PhilippRom/Styrocutter-1.0/Renderings/03 Stangenhalter.jpg

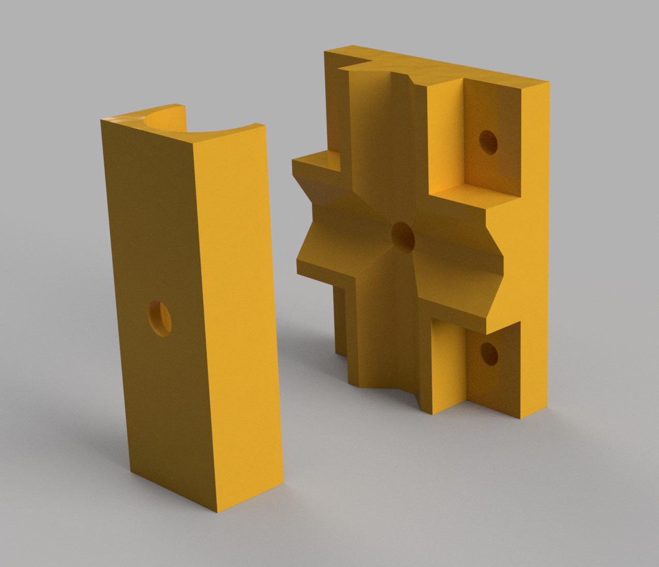
Renderings/03 Stangenhalter.jpg
