PhilippRom/Styrocutter-1.0/Renderings/06 Queranschlag.jpg

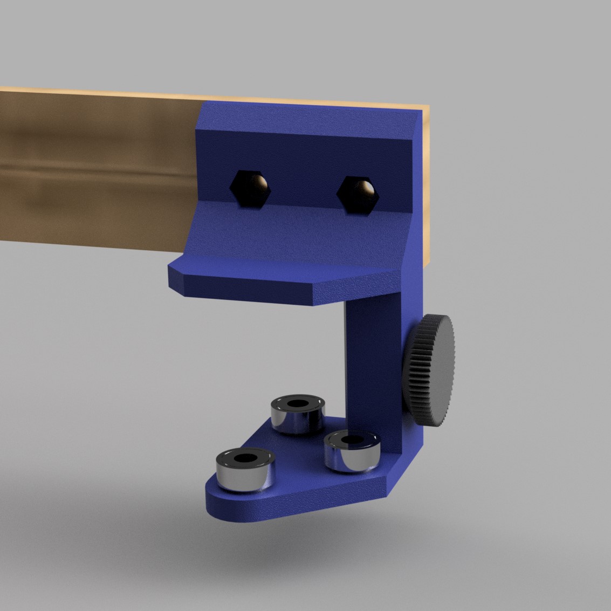
Renderings/06 Queranschlag.jpg
