PhilippRom/Styrocutter-1.0/README.md

# Styrocutter-1.0
Der Styrocutter für die Schule wurde im Rahmen einer Bachelorarbeit entworfen.
Er basiert auf einem einfachen Widerstandsdraht, welcher durch Erhitzung diverses Material, wie Styropor, Styrodur und Schaumstoffe schneiden kann.

Der Styrocutter hat das Ziel, die goldene Mitte zwischen billigen Plastik-Geräten (die es auf Thingiverse in vielen Variationen gibt) und teuren Aluminiumgeräten zu sein.
Durch die Kombination aus 3D gedruckten Teilen, sowie soliden Materialien, die in Baumärkten leicht erhältlich sind erreicht er eine sehr gute Qualität bei gleichzeitig niedrigem Preis.

Mittels des kugelgelagerten Queranschlags und der passgenauen Spannmanschette sind Schneiddicke, sowie Winkel und Spannung des Drahts schnell eingestellt.
Die Drahtretention im Tisch ist so ausgeführt, dass der Draht ohne das Gerät umdrehen zu müssen gewechselt werden kann.
Genauso wurde die Retention des Arms so konstruiert, dass das Gerät schnell, platzsparend in Fächern oder Regalen verstaut werden kann.
Ein zusätzlich ausdruckbares Add-On ermöglicht sogar Kreisschnitte.

Die Stromversorgung wird mittels Bananenstecker eines Labornetzteils gewährleistet. (gewöhnlich werden 5V und ca. 2A benötigt)

Durch das modulare System und die robusten Teile ist das Gerät gut skalierbar, sodass der Schneidtisch größer oder kleiner ausgeführt werden kann.

Der Styrocutter kann auch online angeschaut werden! https://a360.co/2YiIsqU

Die gesammelten Dateien, Schaltpläne und Materiallisten können hier frei abgerufen werden: https://github.com/PhilippRom/Styrocutter-1.0
