PhilippRom/Styrocutter-1.0/CAD/Zahnradparameter.jpg

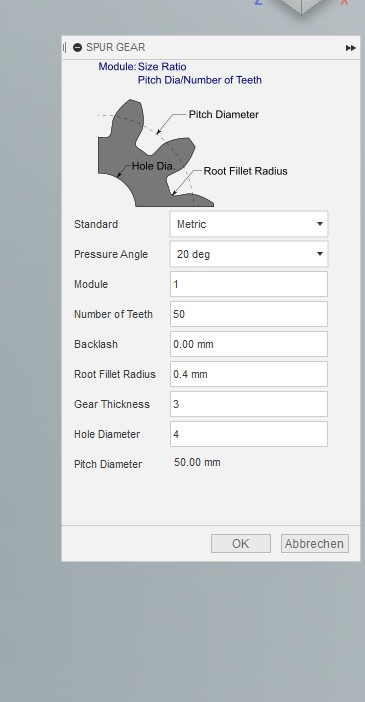
CAD/Zahnradparameter.jpg
