PhilippRom/Styrocutter-1.0/Renderings/01 Überblick 1.jpg

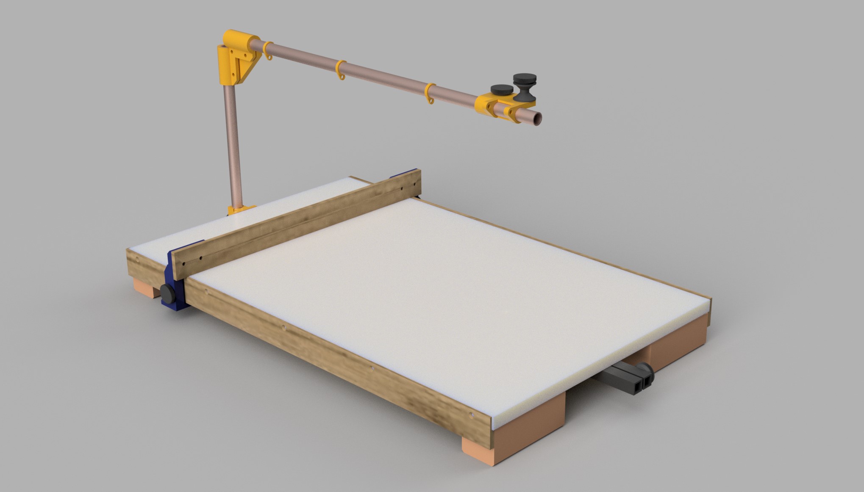
Renderings/01 Überblick 1.jpg
