PhilippRom/Styrocutter-1.0/Renderings/02 Überblick 2.jpg

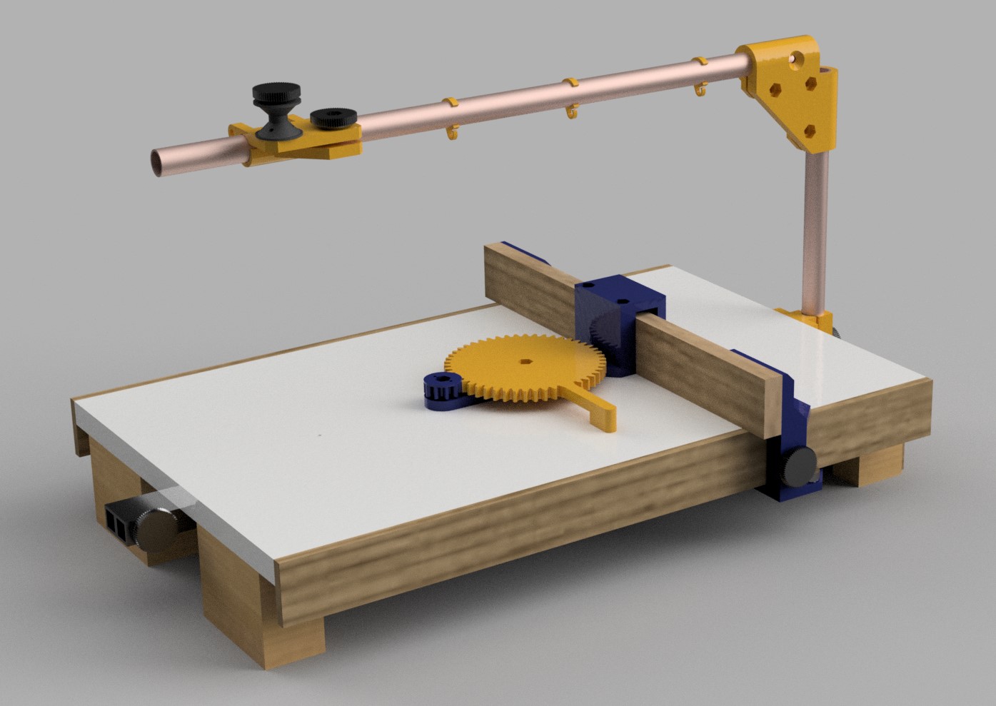
Renderings/02 Überblick 2.jpg
