PhilippRom/Styrocutter-1.0/Renderings/04 Stangeneck.jpg

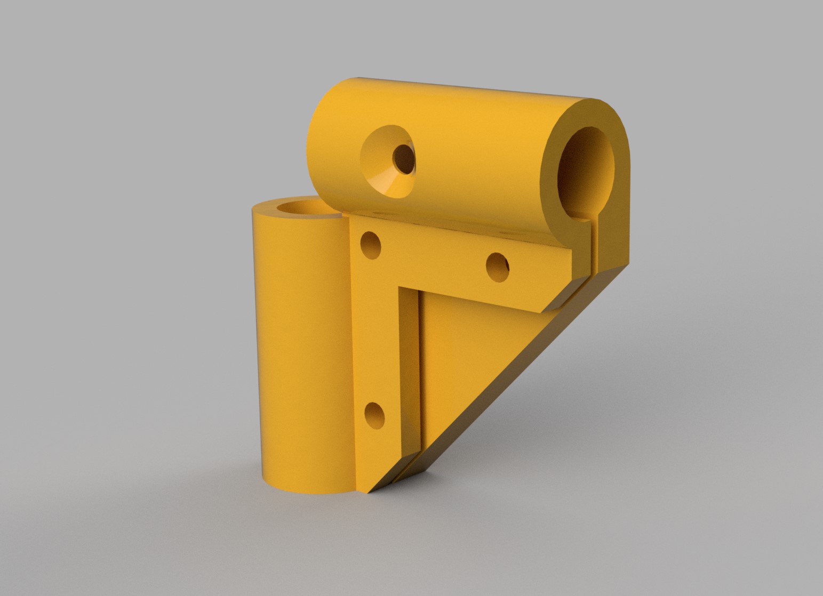
Renderings/04 Stangeneck.jpg
