PhilippRom/Styrocutter-1.0/Renderings/05 Drahtspanner.jpg

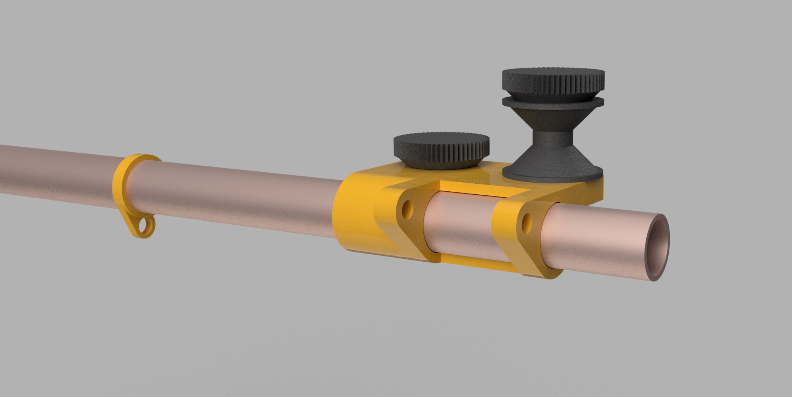
Renderings/05 Drahtspanner.jpg
