PhilippRom/Styrocutter-1.0/Renderings/07 Drehräder M4.jpg

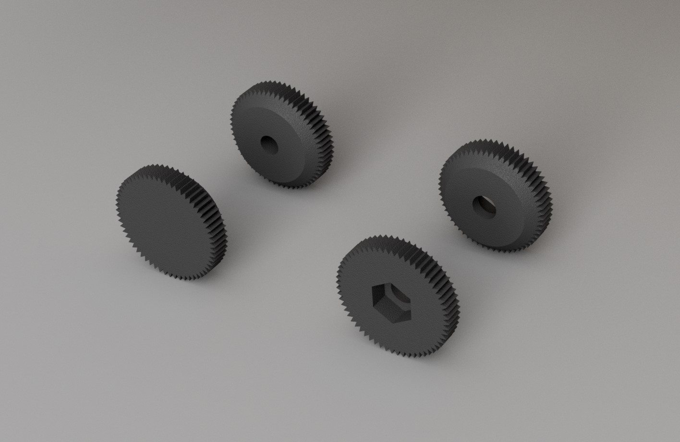
Renderings/07 Drehräder M4.jpg
