PhilippRom/Styrocutter-1.0/Materialliste/BOM Styrocutter.pdf

## Materialliste Thermosäge 1.0

Bauhaus:
Spanplatte 12mm | Dekorplatte Frontweiß, 12mm, 220 x 330 mm | ca € 2,00 | Zuschnitt direkt im Bauhaus
Alu Quadratrohr | 1 m x 11,5 mm x 11,5 mm, Aluminium | € 3,10 | https://www.bauhaus.at/metallprofile-kunststoffprofile/kantoflex-quadratrohr/p/10521785
Buchenleiste 3mm | 0,95 m x 29 mm x 3 mm, Buche, Unbehandelt | € 2,70 | https://www.bauhaus.at/rechteckleisten/profiles-and-more-rechteckleiste/p/20754402
Kupferrohr 12mm | Durchmesser: 12 mm, Länge: 1 m | € 6,10 | https://www.bauhaus.at/rohrleitungen/kupferrohr/p/13640962
Breite Beilagscheiben | Innendurchmesser 4,3mm, Außendurchmesser 15mm | € 2,30 | https://www.bauhaus.at/unterlegscheiben-dichtungsringe/profi-depot-karosseriescheibe-vz/p/10826631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
M4 Gewindeschrauben | Linsenkopf, werden passend gekürzt | € 5,55 | https://www.bauhaus.at/gewindeschrauben/profi-depot-gewindeschraube-vz/p/10807698
M4 Stoppmuttern | im Werksaal vorhanden | | https://www.bauhaus.at/stoppmuttern/profi-depot-stoppmutter-vz/p/10825876
M4 Muttern | im Werksaal vorhanden | | https://www.bauhaus.at/sechskantmuttern/profi-depot-sechskantmutter-vz/p/10825632
M4 Unterlegscheibe | im Werksaal vorhanden | | https://www.bauhaus.at/unterlegscheiben-dichtungsringe/profi-depot-unterlegscheibe/p/10826435
Fichte Leiste 20x40 | im Werksaal vorahnden, Reste durchschauen | | https://www.bauhaus.at/rechteckleisten/amco-rechteckleiste/p/21021880
diverse Spax Schrauben | im Werksaal vorhanden | | bauhaus.at

Conrad:
Kugellager 4x310 | 6 Stück Reely RC-Car Kugellager | 6 x 2,99 € = € 17,94 | https://www.conrad.at/de/p/reely-rc-car-kugellager-chromstahl-innen-durchmesser-4-mm-aussen-durchmesser-10-mm-drehzahl-max-54000-u-min-229656.html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
Kabel | im Werksaal vorhanden, mind. 0,14mm² | | https://www.conrad.at/de/p/tru-components-1565203-litze-2-x-0-14-mm-schwarz-rot-50-m-1565203.html
Bananensteckerbuchse | zum Einschrauben und Verlöten, rot/schwarz | 2x 2,29 € = € 4,58 | https://www.conrad.at/de/p/sks-hirschmann-bil-20-laborbuchse-buchse-einbau-vertikal-stift-4-mm-rot-1-st-734934.html
| | | bzw. https://www.conrad.at/de/p/sks-hirschmann-bil-20-laborbuchse-buchse-einbau-vertikal-stift-4-mm-schwarz-1-st-734926.html

Archidelis:
Heizdraht | speziell für Styrocutter, alternativ eine E-Gitarrenseite | € 6,90 | https://www.archidelis.at/Werkstatt-Buero-Diverses/Maschinen-Werkzeuge/Maschinen-Zubehoer/Styrocut-Hartschaumsaegen-Zubehoer/Drahtspule-fuer-Styrocut-L-10m.html
| | | unhandlichere Alternative von Conrad: https://www.conrad.at/de/p/thomsen-widerstandsdraht-widerstand-m-5-65-m-10-m-421201.html
In Summe | € 51,17
