PhilippRom/Styrocutter-1.0/STL/Kreisschneider/Spur Gear (10 teeth).stl

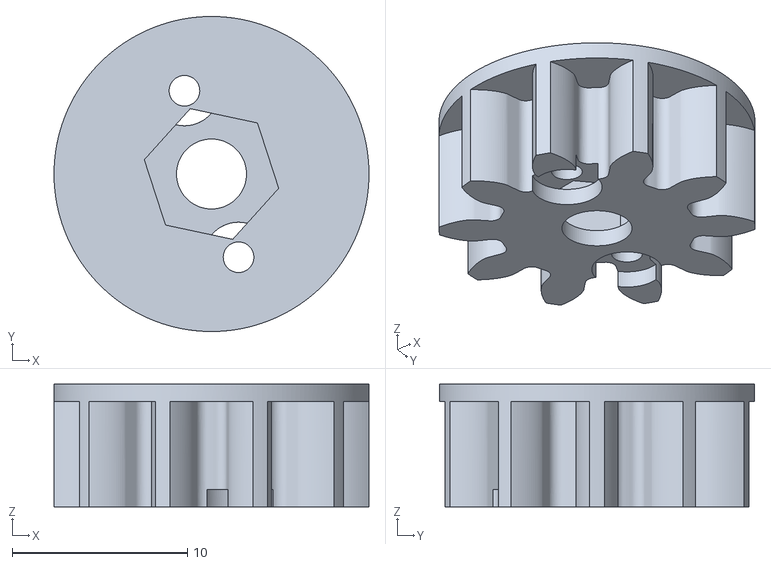
[picture p9: CAD file, 2021-10-03]
STL/Kreisschneider/Spur Gear (10 teeth).stl
18.0 x 18.0 x 7.00
