PhilippRom/Styrocutter-1.0/STL/Rohreckverbinder.stl

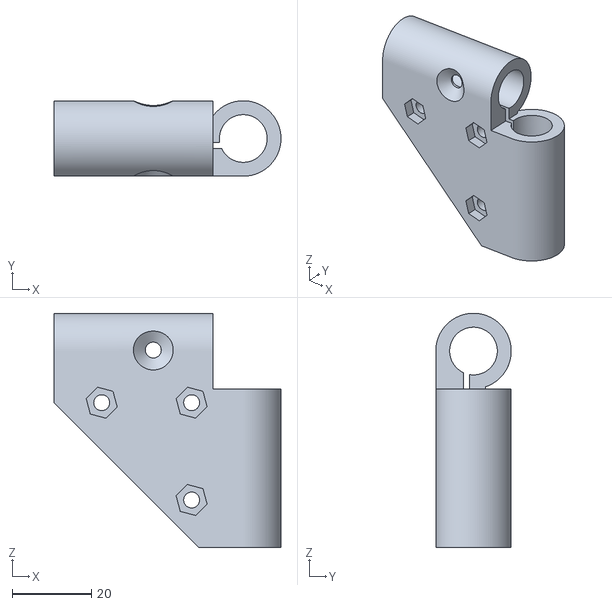
[picture p10: CAD file, 2021-10-03]
STL/Rohreckverbinder.stl
57.1 x 19.0 x 59.0
