PhilippRom/Styrocutter-1.0/STL/Kreisschneider/Retention.stl

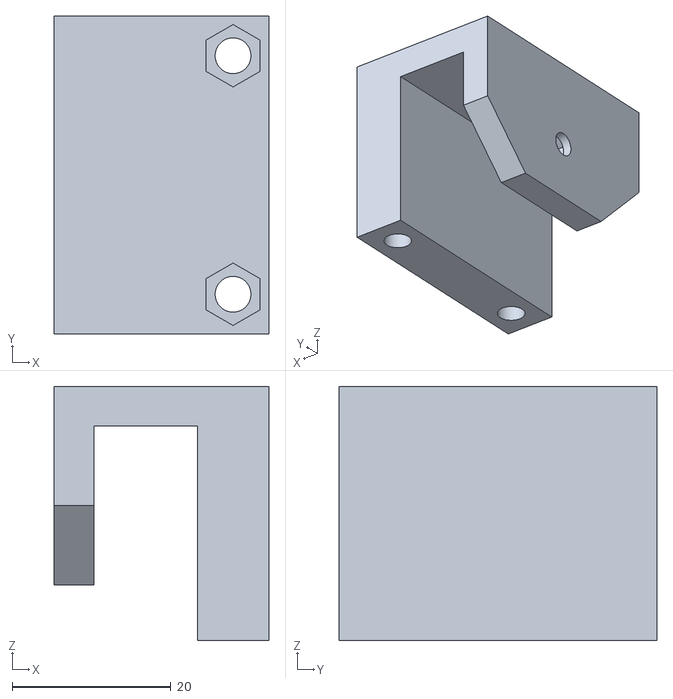
[picture p11: CAD file, 2021-10-03]
STL/Kreisschneider/Retention.stl
27.0 x 40.0 x 32.0
