PhilippRom/Styrocutter-1.0/STL/Spannprofilmutterhalter.stl

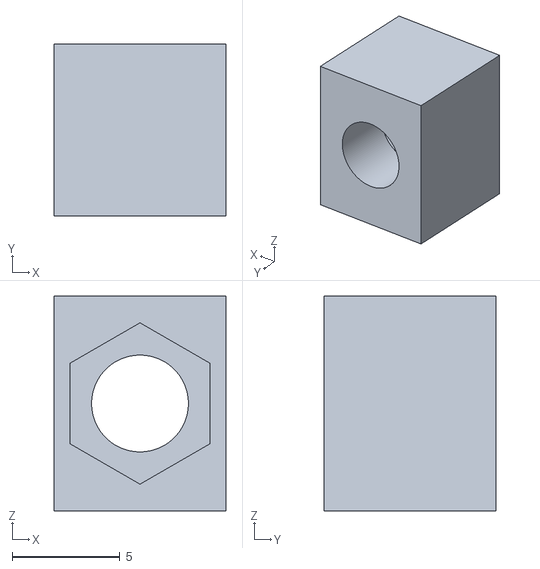
[picture p12: CAD file, 2021-10-03]
STL/Spannprofilmutterhalter.stl
8.00 x 8.00 x 10.0
