PhilippRom/Styrocutter-1.0/STL/Kreisschneider/Spur Gear (50 teeth).stl

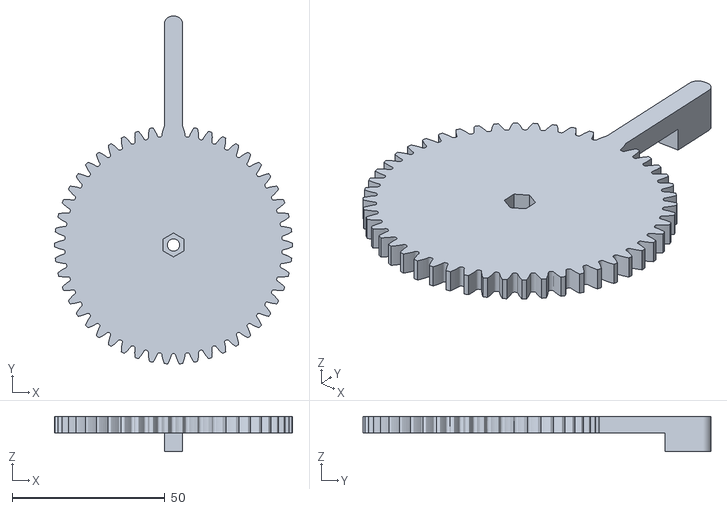
[picture p13: CAD file, 2021-10-03]
STL/Kreisschneider/Spur Gear (50 teeth).stl
78.0 x 114.0 x 11.5
