PhilippRom/Styrocutter-1.0/STL/Schlitten 2.stl

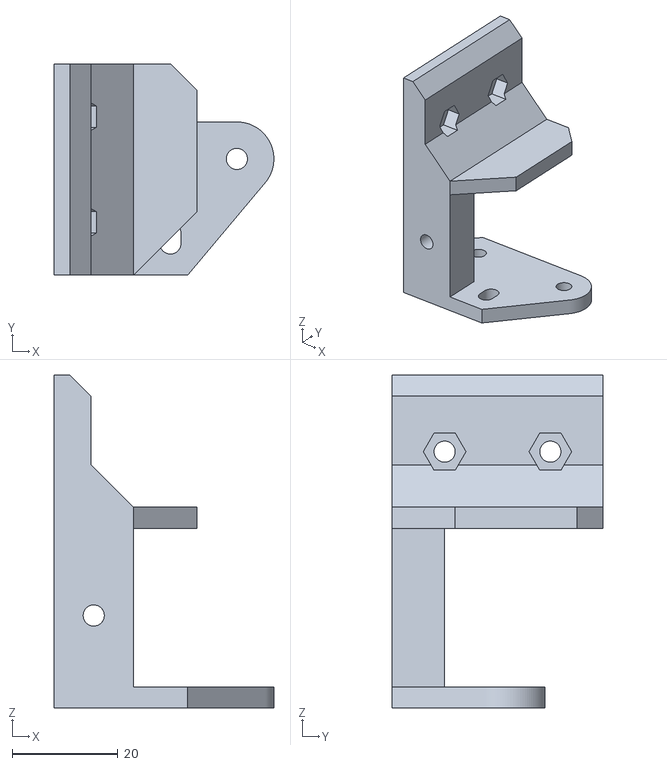
[picture p14: CAD file, 2021-10-03]
STL/Schlitten 2.stl
41.6 x 40.0 x 63.0
