PhilippRom/Styrocutter-1.0/STL/Kreisschneider/Bottom.stl

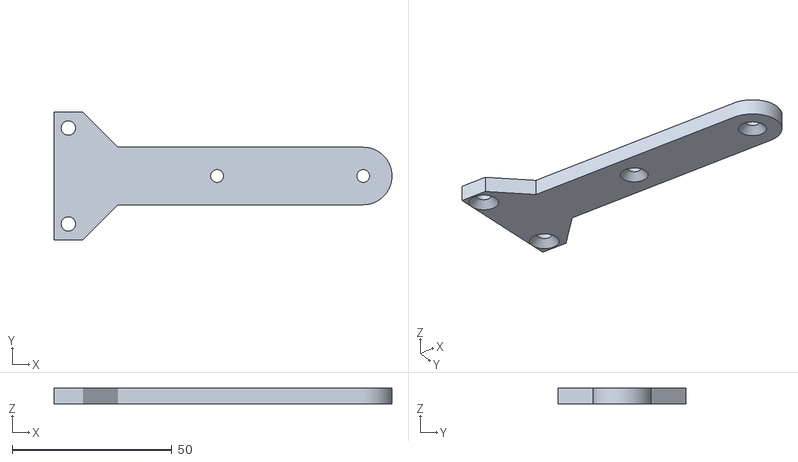
[picture p15: CAD file, 2021-10-03]
STL/Kreisschneider/Bottom.stl
105.7 x 40.0 x 5.00
