PhilippRom/Styrocutter-1.0/STL/Spannlippe 2x.stl

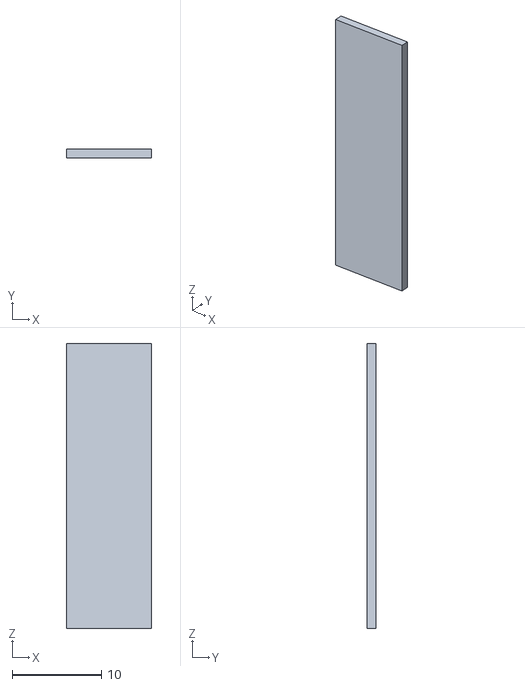
[picture p16: CAD file, 2021-10-03]
STL/Spannlippe 2x.stl
9.50 x 1.00 x 32.0
