PhilippRom/Styrocutter-1.0/STL/Kabelführung 3x.stl

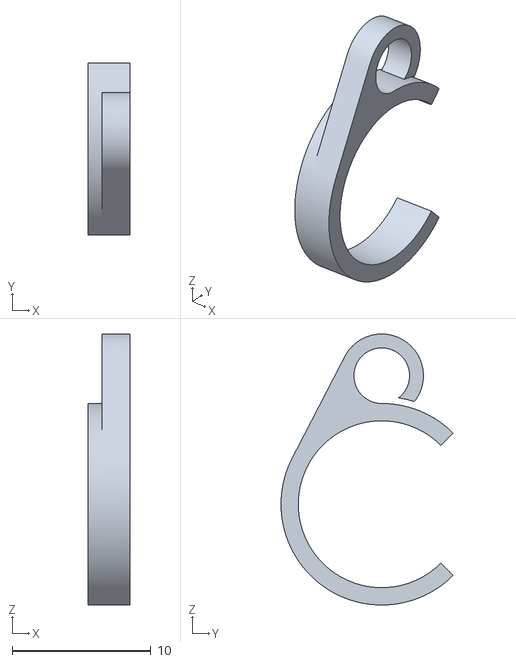
[picture p17: CAD file, 2021-10-03]
STL/Kabelführung 3x.stl
3.00 x 12.4 x 19.5
