PhilippRom/Styrocutter-1.0/STL/Spannmanschette.stl

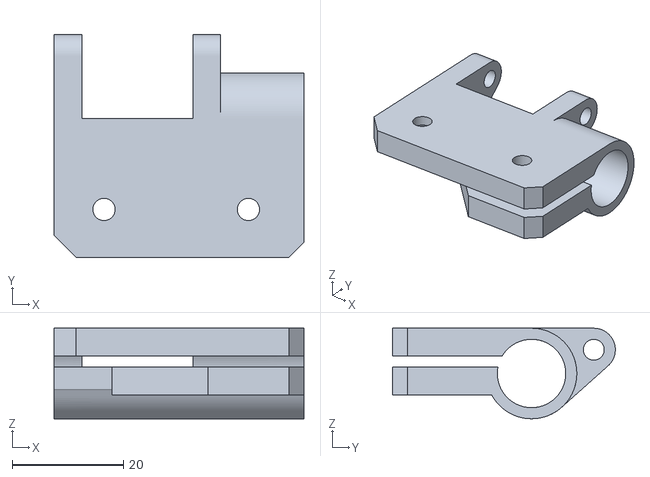
[picture p18: CAD file, 2021-10-03]
STL/Spannmanschette.stl
45.0 x 40.1 x 16.3
