PhilippRom/Styrocutter-1.0/STL/Rohrretention 1.stl

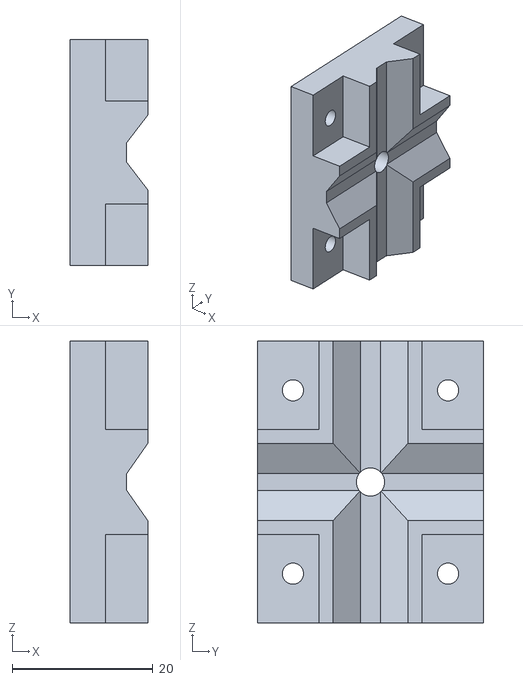
[picture p19: CAD file, 2021-10-03]
STL/Rohrretention 1.stl
11.0 x 32.0 x 40.0
