PhilippRom/Styrocutter-1.0/STL/Rohrretention 2.stl

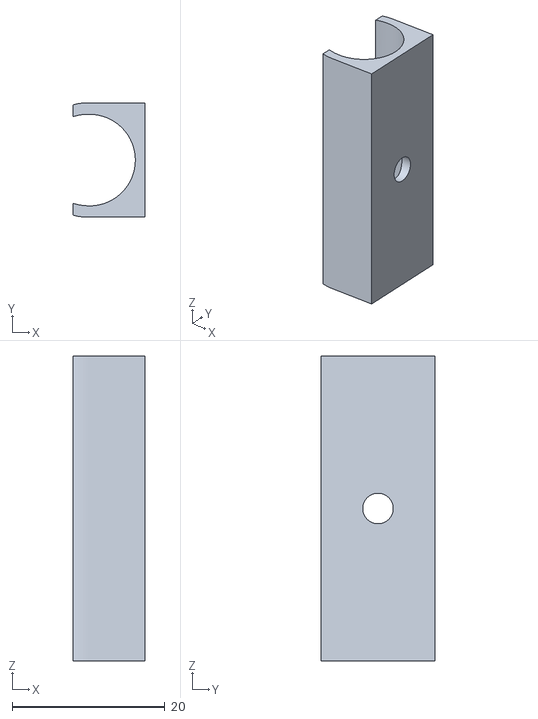
[picture p20: CAD file, 2021-10-03]
STL/Rohrretention 2.stl
9.50 x 15.0 x 40.0
