PhilippRom/Styrocutter-1.0/STL/Thumbwheel M4 Nut 4x.stl

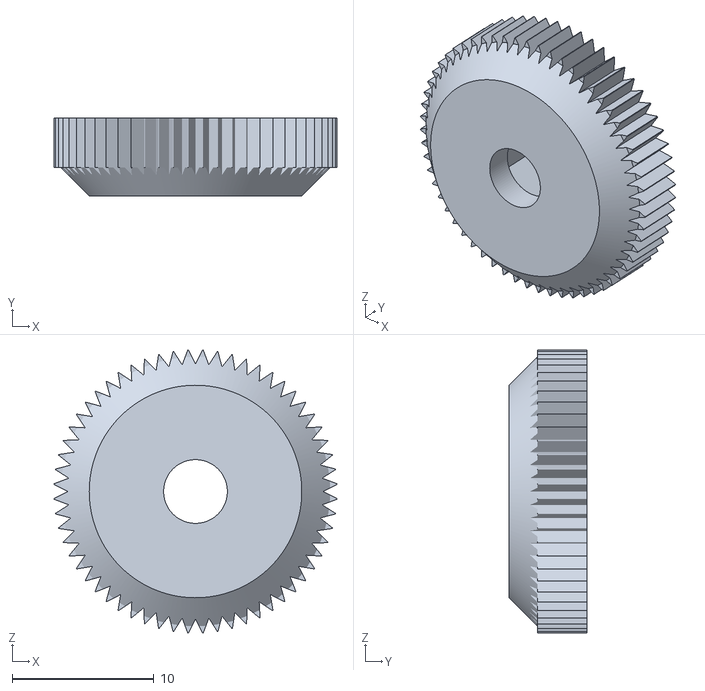
[picture p21: CAD file, 2021-10-03]
STL/Thumbwheel M4 Nut 4x.stl
20.0 x 5.50 x 20.0
