PhilippRom/Styrocutter-1.0/(list of files, cad)

Other CAD files:
STL/Schlitten 1.stl
STL/Thumbwheel M4 Screw 5x.stl
