PhilippRom/Styrocutter-1.0/(commit log)

2021-10-02 Create stl
2021-10-03 Create Online CAD Viewer
2021-10-03 Create bom
